jdiouris/calculatrice/masques/masque.pdf

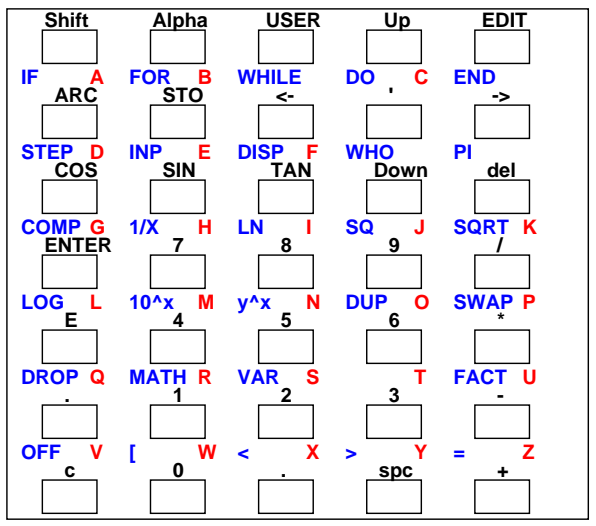
[picture p1: figure]
Shift; Alpha; USER; EDIT; ARC; STO; FOR B; WHILE; END; COS; STEP D; SIN; INP; TAN; DISP F; Down; WHO; del; ENTER; COMP G; SQRT K; LOG L; DUP O; SWAP P; DROP Q; MATH R; VAR S; FACT U; OFF; spc
