jdiouris/calculatrice/3d/dessous.stl

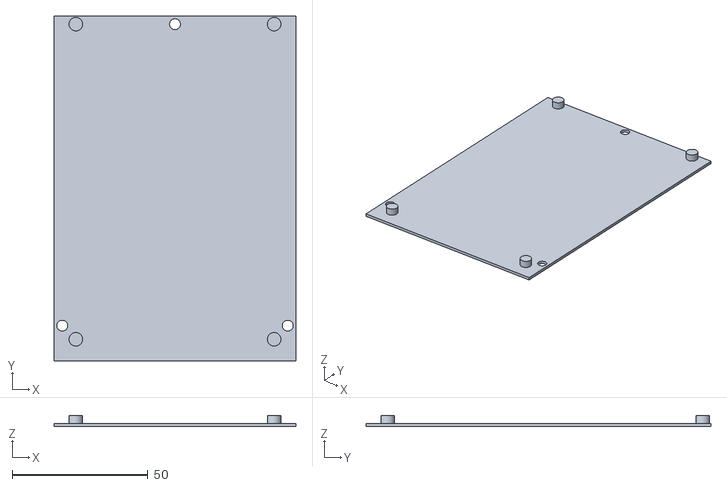
[picture p2: CAD file, 2020-02-18]
3d/dessous.stl
89.0 x 127.0 x 4.20
