jdiouris/calculatrice/3d/entretoiseLCD.stl

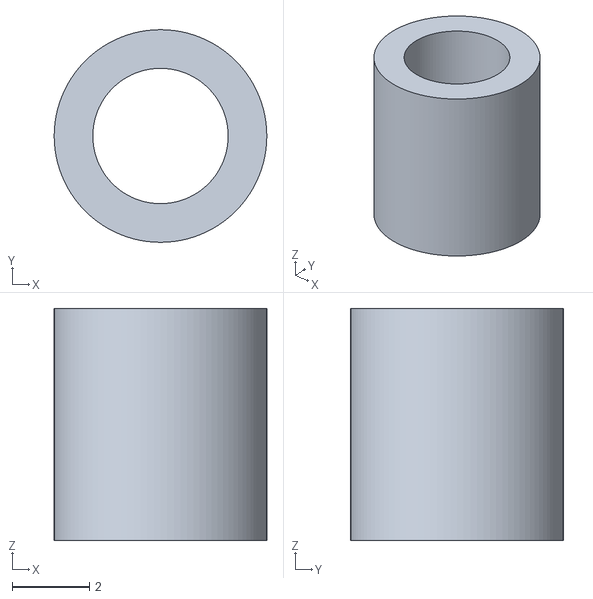
[picture p3: CAD file, 2020-01-26]
3d/entretoiseLCD.stl
5.50 x 5.50 x 6.00
