jdiouris/calculatrice/(list of files, cad)

Other CAD files:
3d/boitier.stl
