jdiouris/calculatrice/hardware/calculatrice/calculatrice.kicad_pcb

## KiCad design hardware/calculatrice/calculatrice.kicad_pcb (2020-01-23)

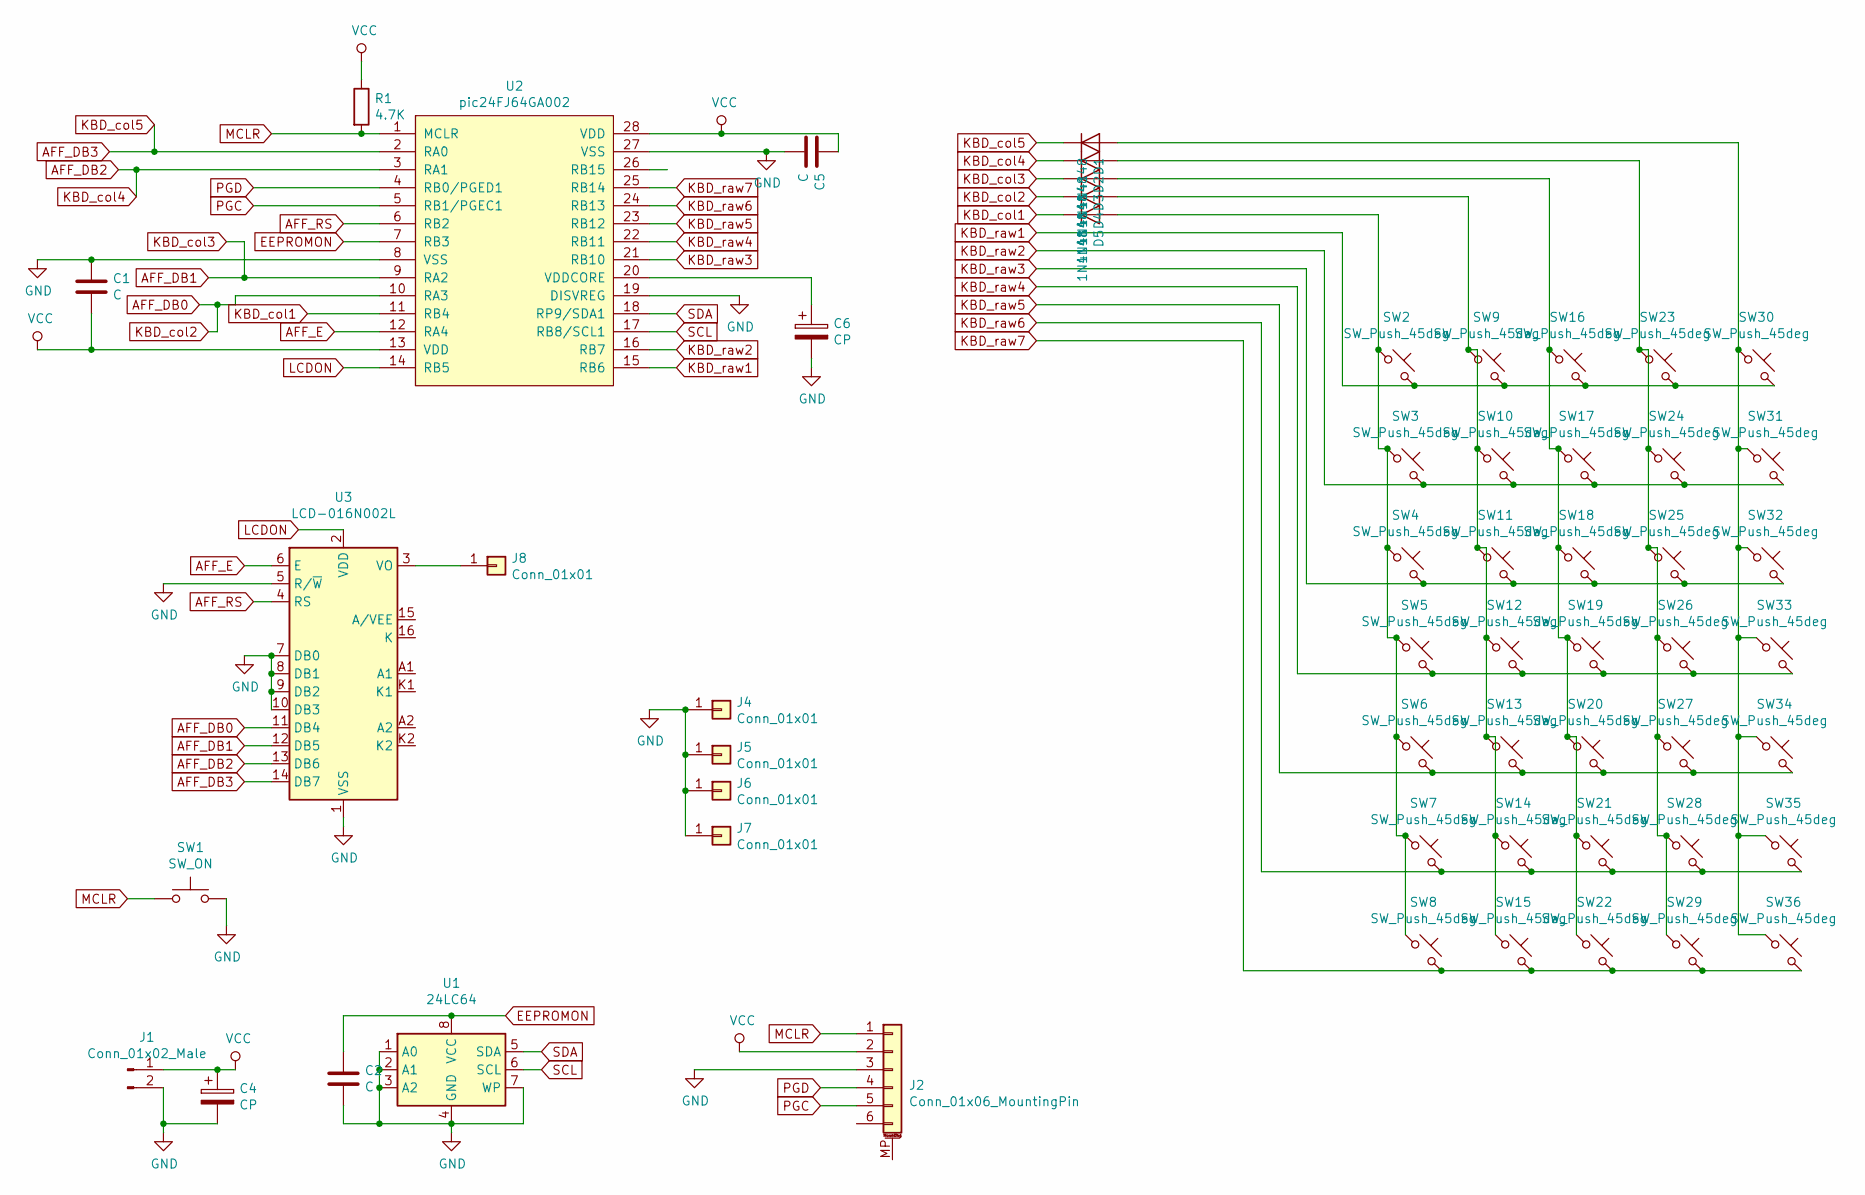
[picture p4: schematic calculatrice.sch]

Parts:
C1, C2, C5: C; C_Rect_L4_W2.5_P2.5
C4: CP; C_Rect_L4_W2.5_P2.5
C6: CP; C_Radial_D5_L6_P2.5
D1, D2, D3, D4, D5: 1N4148; D_DO-35_SOD27_P7.62mm_Horizontal
J1: Conn_01x02_Male; Pin_Header_Straight_1x02
J2: Conn_01x06_MountingPin; Pin_Header_Angled_1x06
J4, J5, J6, J7, J8: Conn_01x01; 1pin
R1: 4.7K; R3-LARGE_PADS
SW1: SW_ON; SW_PUSH-12mm
SW2, SW3, SW4, SW5, SW6, SW7, SW8, SW9, SW10, SW11, SW12, SW13, SW14, SW15, SW16, SW17, SW18, SW19, SW20, SW21, SW22, SW23, SW24, SW25, SW26, SW27, SW28, SW29, SW30, SW31, SW32, SW33, SW34, SW35, SW36: SW_Push_45deg; SW_PUSH-12mm
U1: 24LC64; DIP-8_W7.62mm_LongPads
U2: pic24FJ64GA002; DIP-28_W7.62mm_LongPads
U3: LCD-016N002L; LCD16

Connections:
AFF_DB0: D4.1 (K), U2.10 (RA3), U3.11 (DB4)
AFF_DB1: D3.1 (K), U2.9 (RA2), U3.12 (DB5)
AFF_DB2: D2.1 (K), U2.3 (RA1), U3.13 (DB6)
AFF_DB3: D1.1 (K), U2.2 (RA0), U3.14 (DB7)
AFF_E: U2.12 (RA4), U3.6 (E)
AFF_RS: U2.6 (RB2), U3.4 (RS)
EEPROMON: C2.1, U1.8 (VCC), U2.7 (RB3)
GND: C1.1, C2.2, C4.2, C5.2, C6.2, J1.2, J2.3, J4.1, J5.1, J6.1, J7.1, SW1.2, U1.1 (A0), U1.2 (A1), U1.3 (A2), U1.4 (GND), U1.7 (WP), U2.8 (VSS), U2.19 (DISVREG), U2.27 (VSS), U3.1 (VSS), U3.5 (R/~W), U3.7 (DB0), U3.8 (DB1), U3.9 (DB2), U3.10 (DB3)
KBD_col1: D5.1 (K), U2.11 (RB4)
KBD_raw1: SW2.2, SW9.2, SW16.2, SW23.2, SW30.2, U2.15 (RB6)
KBD_raw2: SW3.2, SW10.2, SW17.2, SW24.2, SW31.2, U2.16 (RB7)
KBD_raw3: SW4.2, SW11.2, SW18.2, SW25.2, SW32.2, U2.21 (RB10)
KBD_raw4: SW5.2, SW12.2, SW19.2, SW26.2, SW33.2, U2.22 (RB11)
KBD_raw5: SW6.2, SW13.2, SW20.2, SW27.2, SW34.2, U2.23 (RB12)
KBD_raw6: SW7.2, SW14.2, SW21.2, SW28.2, SW35.2, U2.24 (RB13)
KBD_raw7: SW8.2, SW15.2, SW22.2, SW29.2, SW36.2, U2.25 (RB14)
LCDON: U2.14 (RB5), U3.2 (VDD)
MCLR: J2.1, R1.2, SW1.1, U2.1 (MCLR)
unnamed: C6.1, U2.20 (VDDCORE)
unnamed: D1.2 (A), SW30.1, SW31.1, SW32.1, SW33.1, SW34.1, SW35.1, SW36.1
unnamed: D2.2 (A), SW23.1, SW24.1, SW25.1, SW26.1, SW27.1, SW28.1, SW29.1
unnamed: D3.2 (A), SW16.1, SW17.1, SW18.1, SW19.1, SW20.1, SW21.1, SW22.1
unnamed: D4.2 (A), SW9.1, SW10.1, SW11.1, SW12.1, SW13.1, SW14.1, SW15.1
unnamed: D5.2 (A), SW2.1, SW3.1, SW4.1, SW5.1, SW6.1, SW7.1, SW8.1
unnamed: J8.1, U3.3 (VO)
PGC: J2.5, U2.5 (RB1/PGEC1)
PGD: J2.4, U2.4 (RB0/PGED1)
SCL: U1.6 (SCL), U2.17 (RB8/SCL1)
SDA: U1.5 (SDA), U2.18 (RP9/SDA1)
VCC: C1.2, C4.1, C5.1, J1.1, J2.2, R1.1, U2.13 (VDD), U2.28 (VDD)

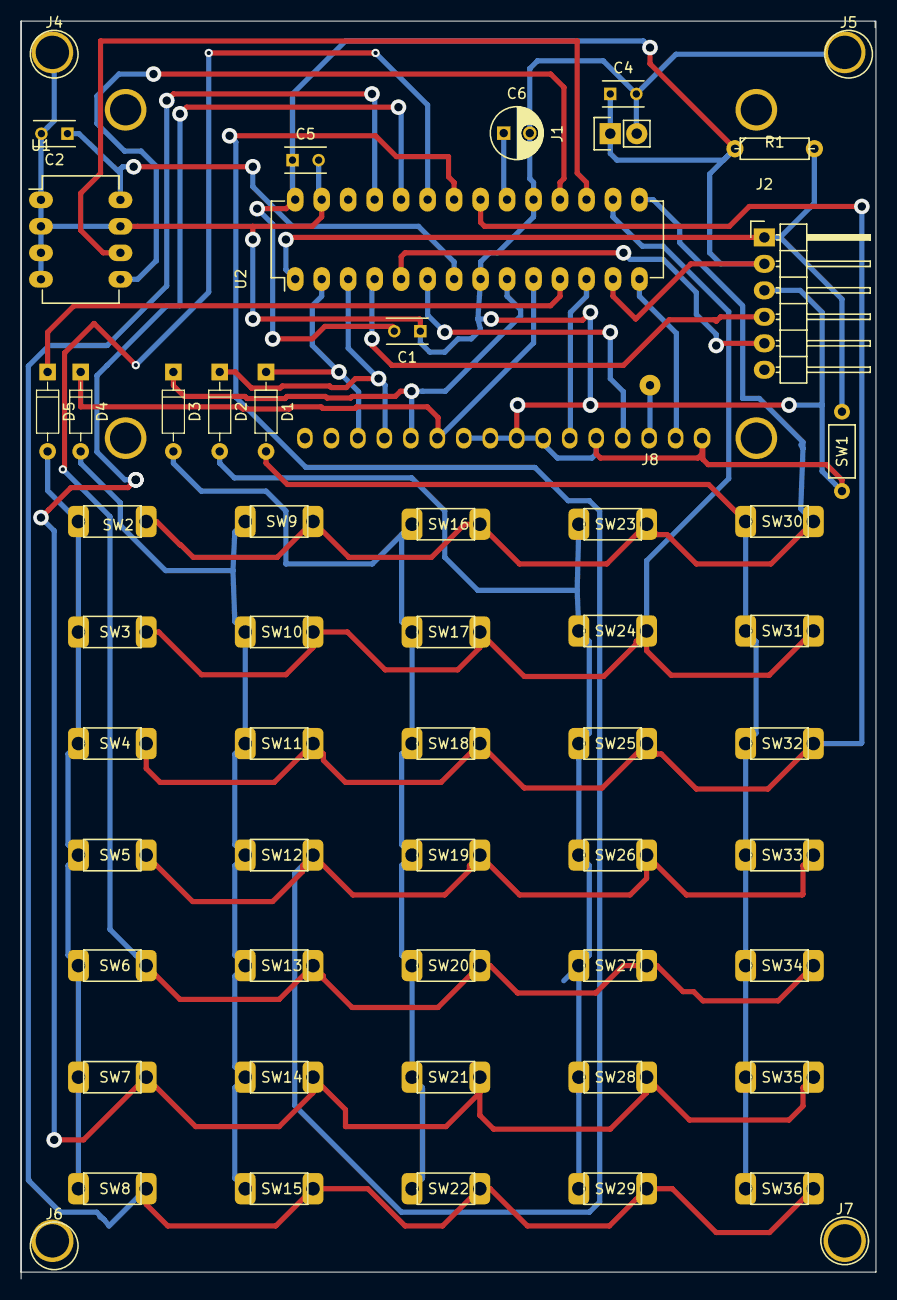
[picture p5: board calculatrice.kicad_pcb from above]

Board: 2 copper layers, 82.0 x 120.7 mm, 57 parts (1 on the bottom side), 30 nets.
