jdiouris/calculatrice/(commit log)

2020-01-26 Developpement
    RPN Calculator protptype
    [calculatrice.sch, entretoiseLCD.scad, entretoiseLCD.stl]
2020-02-16 Function edit
    [boitier.scad, boitier.stl, dessous.stl]
2020-02-18 func edit
    [boitier.scad, boitier.stl, dessous.stl]
